Bemnet-Suleman/SAFE_LINK/docs/SAFE_LINK_Final_Requirements_Specifications_Design.docx

SAFE LINK

Requirements, Technical Specifications
and Final System Design

Wearable-Based Group Safety and Participant Monitoring System

Project Documentation
Embedded Systems & IoT
August 2026

# 1. System Requirements

## 1.1 Functional Requirements

- Participant Identification: Each wearable shall have a unique device identifier and shall be associated with a participant and group during registration.
- Emergency SOS Function: A deliberate long-press of a physical SOS button shall generate a high-priority alert containing device identification, available location information, timestamp, and battery status.
- Location Monitoring: The wearable shall obtain participant location using GNSS and retain the most recent valid position as a clearly identified last-known location when live positioning is unavailable.
- Movement and Possible-Fall Detection: An IMU shall monitor movement. The prototype shall use acceleration, orientation change, and subsequent inactivity as indicators of a possible fall.
- Heart-Rate Monitoring: An optical PPG sensor shall periodically measure heart rate as a supporting safety signal, not as a medical diagnosis.
- Battery Monitoring: The system shall monitor battery state and generate low or critical battery warnings.
- Check-in and Attendance: The MVP shall support checkpoint check-in using BLE proximity, with QR-based check-in as a fallback.
- Connection Monitoring: Heartbeat messages shall be used to identify delayed, offline, or unknown devices.
- Geofencing: Organizers shall be able to define safe zones and receive warnings when participants leave them.
- Group-Separation Detection: The system shall identify participants who remain outside a defined distance from their group for a specified period.
- Wearable Integrity Monitoring: A conductive strap loop or equivalent sensor shall detect unexpected wearable removal.
- Organizer Dashboard: The dashboard shall display participant status, location, battery, connection information, and alerts using SAFE, WARNING, CRITICAL, and UNKNOWN states.

## 1.2 Non-Functional Requirements

- Reliability: Sensor and communication failures shall be represented explicitly.
- Low Power Consumption: Adaptive sensor and GNSS sampling shall reduce unnecessary battery use.
- Fail-Safe Operation: Loss of communication shall result in UNKNOWN/OFFLINE rather than SAFE.
- Usability: The dashboard shall emphasize exceptions and actionable alerts.
- Security: Communication and dashboard access shall use appropriate encryption and authentication.
- Privacy: Monitoring information shall be minimized and restricted to authorized organizers.
- Scalability: The prototype shall support a small group of devices with a clear path to larger deployments.
- Maintainability: The system shall use commonly available and well-documented components.

# 2. Technical Specifications

## 2.1 Wearable Hardware

Component | Recommended Specification | Interface | Function
Microcontroller | ESP32-class MCU | — | Main processing and system control
GNSS | u-blox NEO-6M / NEO-M8N class | UART | Participant location
IMU | MPU6050 | I2C | Motion and possible-fall detection
Heart-rate sensor | MAX30102-class PPG | I2C | Supporting heart-rate measurement
Battery fuel gauge | MAX17048-class | I2C | Battery state estimation
Charging IC | TP4056-class | — | Li-ion battery charging
SOS button | Tactile momentary switch | GPIO / interrupt | Emergency alert
Status indicator | LED | GPIO | Status indication
Feedback | Vibration motor | GPIO/PWM | User confirmation
Integrity sensor | Conductive strap loop | GPIO | Removal/tamper detection
Communication | BLE | Wireless | Wearable-to-gateway link

## 2.2 Communication Specifications

The final MVP communication architecture shall use the following structure:

Wearable → BLE → Gateway → Wi-Fi/Cellular → Backend Server → Organizer Dashboard

BLE is the recommended wearable-to-gateway method for the MVP. For larger or more spread-out deployments, a LoRa-based communication layer may be considered as a future upgrade. The gateway shall forward wearable data to the backend and should buffer data during temporary Internet outages.

## 2.3 Software Specifications

### Wearable Firmware

- Read sensors and process movement information.
- Detect local events such as SOS, possible falls, prolonged inactivity, and removal.
- Monitor battery and communication status.
- Buffer important events.
- Control wireless communication and user feedback.

### Gateway Software

- Receive data from multiple wearables.
- Maintain wearable communication.
- Buffer information during Internet outages.
- Forward data to the backend server.

### Backend Server

- Receive telemetry from the gateway.
- Maintain participant and device information.
- Evaluate alert rules.
- Store current participant states.
- Provide data to the organizer dashboard.

### Organizer Dashboard

- Display participant status and locations.
- Show active alerts and last-known locations.
- Display battery and connection information.
- Allow organizers to acknowledge and resolve alerts.

# 3. Final System Design

## 3.1 Overall Architecture

WEARABLE
ESP32 + GNSS + MPU6050 + MAX30102
+ Battery Monitor + SOS + Strap Sensor
|
BLE
v
GATEWAY
|
Wi-Fi / Cellular
v
BACKEND SERVER
Database + Alert Engine
|
v
ORGANIZER DASHBOARD
SAFE / WARNING / CRITICAL / UNKNOWN

## 3.2 Wearable Internal Design

The ESP32 acts as the central controller. It coordinates the sensors, performs initial processing, manages communication, and controls the LED and vibration feedback.

- GNSS → location acquisition through UART.
- MPU6050 → motion and possible-fall detection through I2C.
- MAX30102 → supporting heart-rate measurement through I2C.
- Battery/fuel gauge → battery status through I2C.
- SOS button → emergency input through GPIO/interrupt.
- Conductive strap loop → wearable integrity detection through GPIO.
- BLE → communication from wearable to gateway.
- LED and vibration motor → local user feedback.

## 3.3 Data Flow

1. Sensor Collection: The wearable collects location, motion, heart-rate supporting data, battery state, connection status, and strap-integrity information.

2. Local Processing: The ESP32 processes sensor information and identifies locally detectable events.

3. Wireless Transmission: Normal telemetry is transmitted to the gateway through BLE.

4. Gateway Processing: The gateway receives data from wearables and forwards it through Wi-Fi or cellular connectivity.

5. Backend Analysis: The backend updates participant state and evaluates incoming data against alert rules.

6. Alert Generation: Abnormal conditions generate Warning or Critical alerts.

7. Dashboard Display: The organizer dashboard displays status and required information.

8. Organizer Response: The organizer acknowledges, verifies, acts, and records the resolution.

# 4. Alert Classification

Severity | Examples | Organizer Action
Information / Normal | Normal movement, successful check-in, charging | No immediate action
Warning | Low battery, geofence violation, prolonged inactivity, possible separation, wearable removal | Verify and follow up
Critical | SOS activation; possible fall combined with prolonged inactivity; high-confidence emergency combinations | Immediate acknowledgment and response
Unknown | Communication lost or device unavailable | Manual status verification

# 5. Final MVP Scope

## 5.1 Included in the MVP

- ESP32-based wearable controller
- GNSS location
- MPU6050 movement monitoring
- MAX30102 periodic heart-rate monitoring
- SOS button
- Battery monitoring
- BLE communication
- Gateway communication
- Basic backend/database
- Organizer dashboard
- Basic geofencing
- Basic group-separation detection
- Wearable removal detection
- Alert classification
- Local event buffering

## 5.2 Future Enhancements

- Machine-learning-based fall detection
- Advanced indoor positioning
- NFC/RFID checkpoint systems
- Advanced polygon geofencing
- LoRa as the standard communication method
- Satellite communication
- Solar-assisted charging
- Multi-gateway redundancy
- External camp-management integration

# 6. Final Design Summary

The finalized SAFE LINK system is a wearable-based monitoring platform consisting of an ESP32-controlled wearable, sensors, wireless communication, gateway, backend server, database, alert engine, and organizer dashboard.

The wearable collects safety-related information and performs initial processing. The gateway provides communication between wearable devices and the Internet. The backend processes incoming information and determines whether a participant should be classified as SAFE, WARNING, CRITICAL, or UNKNOWN. The organizer dashboard presents this information in a decision-oriented format.

Development shall be incremental: individual subsystems such as GNSS, motion detection, heart-rate sensing, battery monitoring, and communication should first be tested independently. After validation, the subsystems should be integrated into one wearable before final enclosure and field testing.

The final design is intended to provide an achievable student prototype while clearly separating demonstrated prototype capabilities from future development. SAFE LINK is an organized-group safety and accountability system, not a medical diagnostic system or a military-grade tracking system.

SAFE LINK — Requirements, Specifications and Final Design
