Bemnet-Suleman/SAFE_LINK/hardware/PCB_PCB_SAFELINK_carrier_2026-10-18/EasyEDA(Standard) 6.5.51 - Projects Offline mode 10_18_2026 11_13_48 AM.png

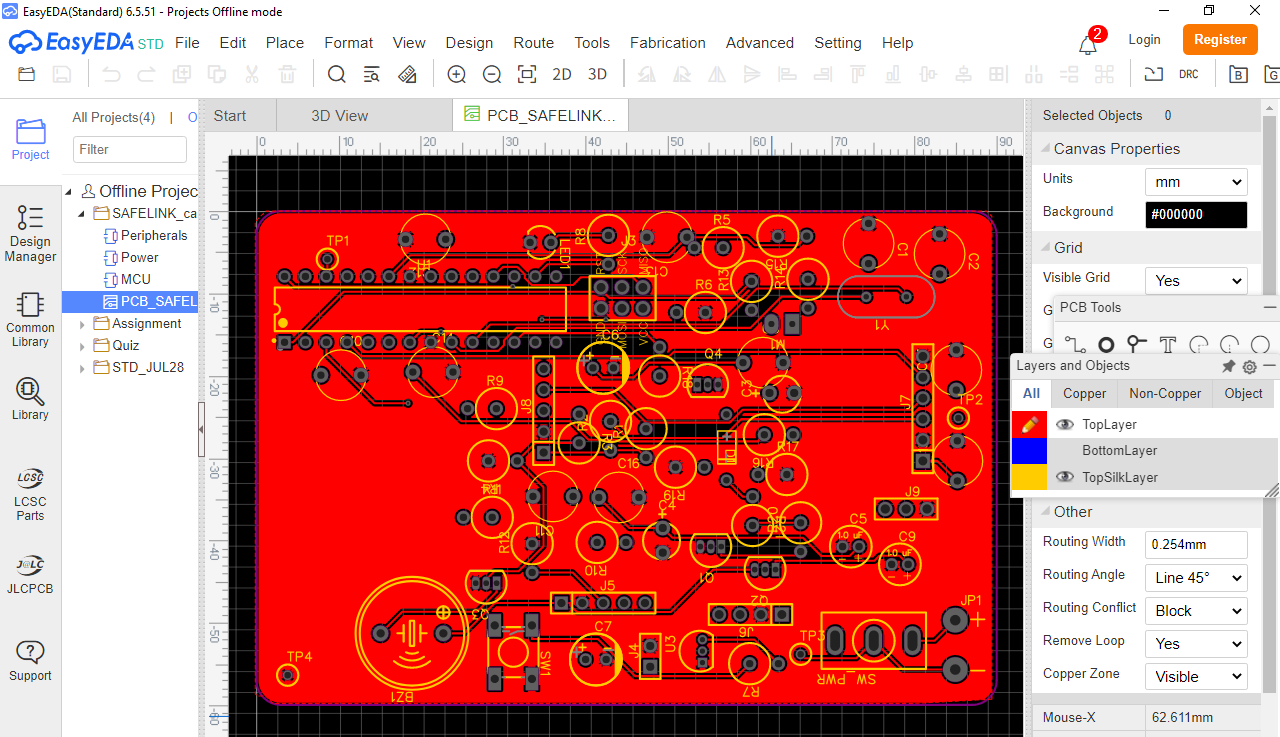
hardware/PCB_PCB_SAFELINK_carrier_2026-10-18/EasyEDA(Standard) 6.5.51 - Projects Offline mode 10_18_2026 11_13_48 AM.png
