Bemnet-Suleman/SAFE_LINK/hardware/PCB_PCB_SAFELINK_carrier_2026-10-18/Screenshot 10_18_2026 11_00_50 AM.png

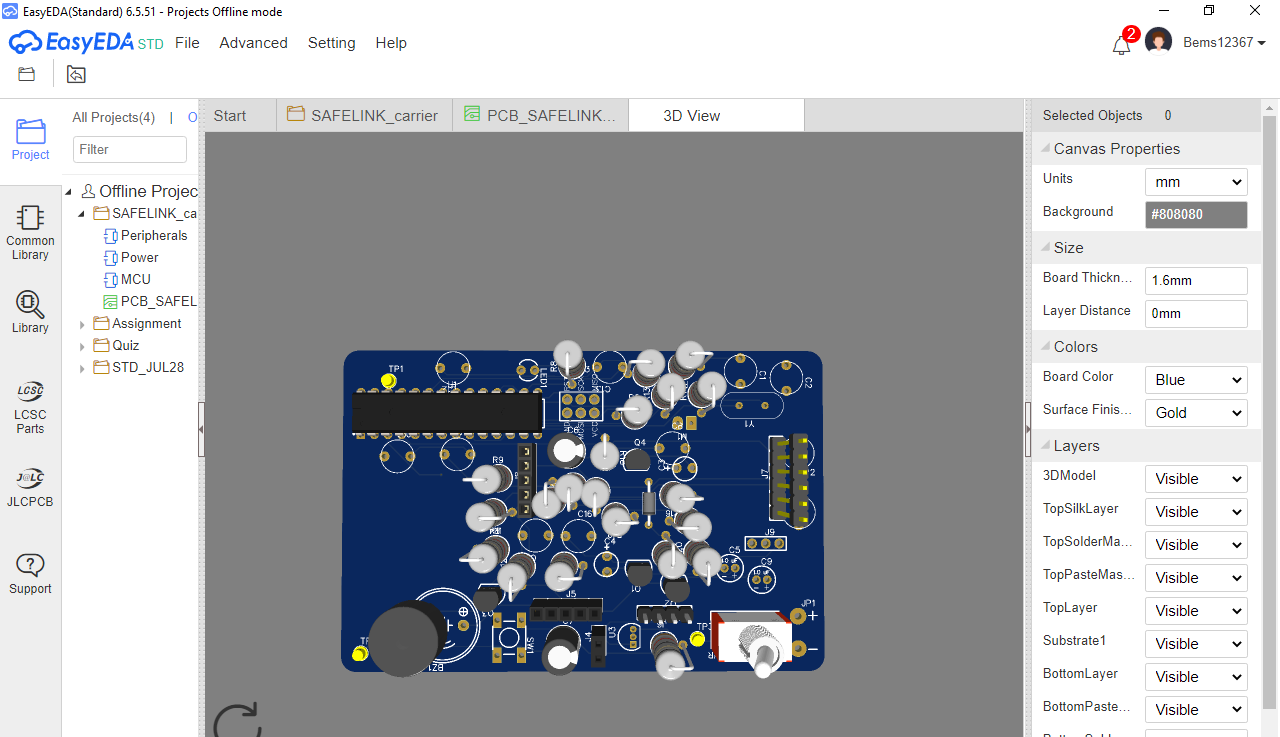
hardware/PCB_PCB_SAFELINK_carrier_2026-10-18/Screenshot 10_18_2026 11_00_50 AM.png
