Bemnet-Suleman/SAFE_LINK/enclosure/A_full_assembly.stl

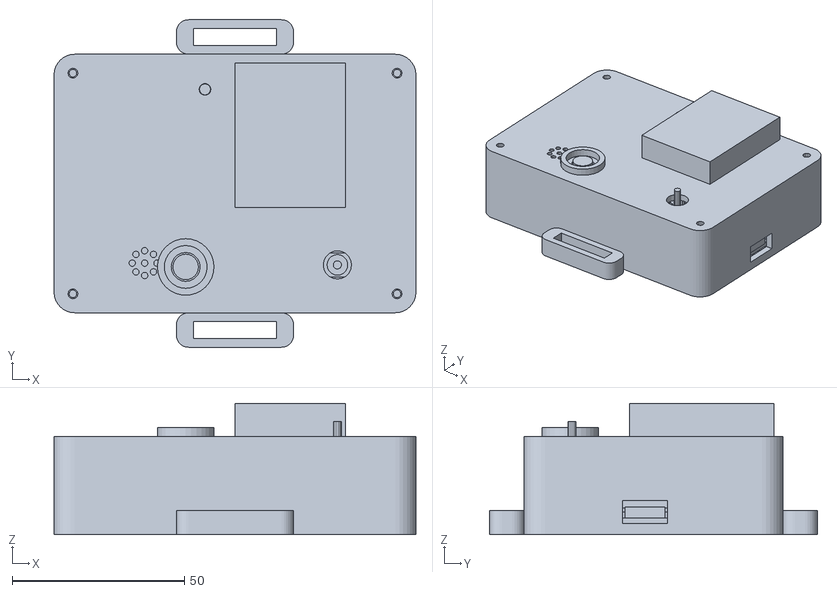
[picture p20: CAD file, 2026-10-19]
enclosure/A_full_assembly.stl
105.0 x 95.0 x 38.0
