Bemnet-Suleman/SAFE_LINK/enclosure/C_full_assembly.stl

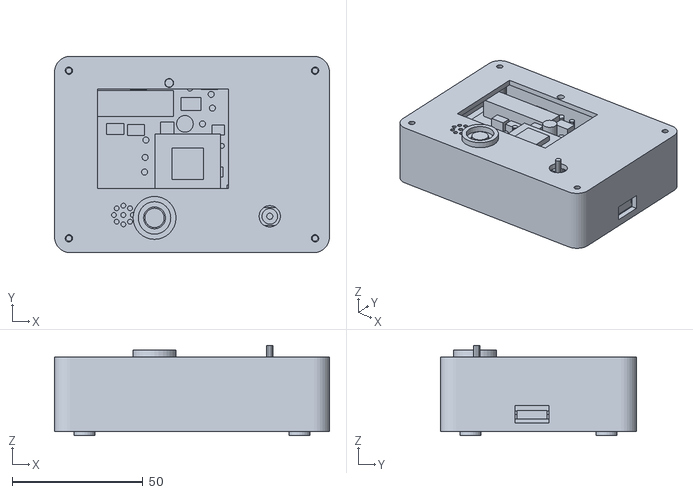
[picture p21: CAD file, 2026-10-19]
enclosure/C_full_assembly.stl
105.0 x 75.0 x 34.4
