Bemnet-Suleman/SAFE_LINK/enclosure/B_full_assembly.stl

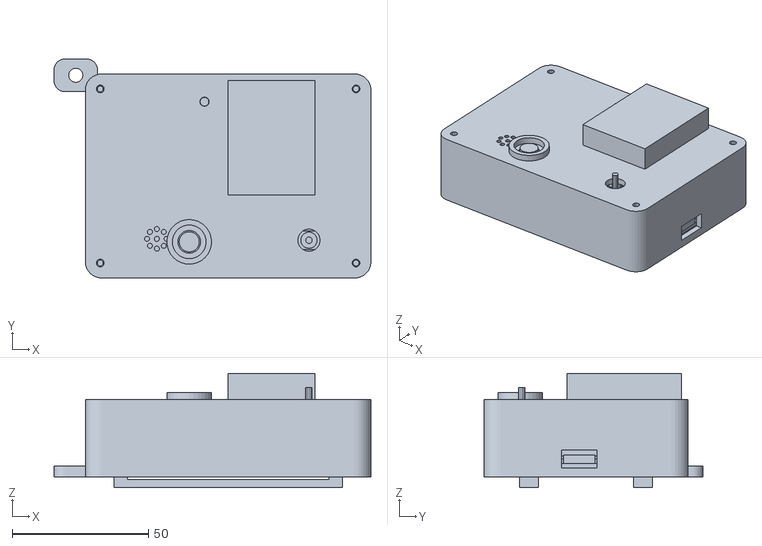
[picture p22: CAD file, 2026-10-19]
enclosure/B_full_assembly.stl
116.5 x 80.5 x 42.0
