Bemnet-Suleman/SAFE_LINK/enclosure/A_lid.stl

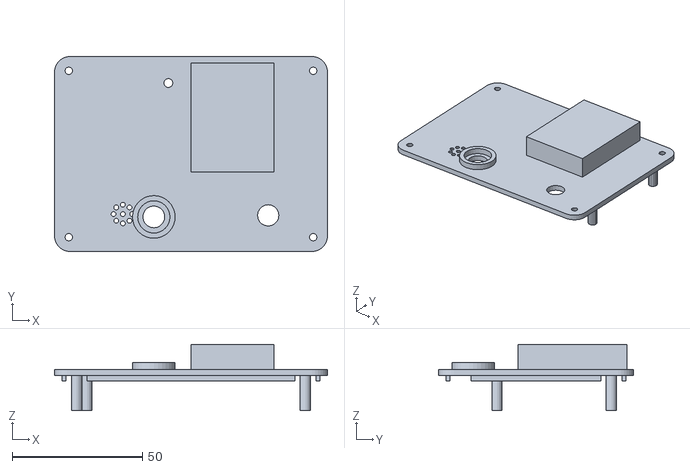
[picture p23: CAD file, 2026-10-19]
enclosure/A_lid.stl
105.0 x 75.0 x 25.4
