Bemnet-Suleman/SAFE_LINK/enclosure/B_base.stl

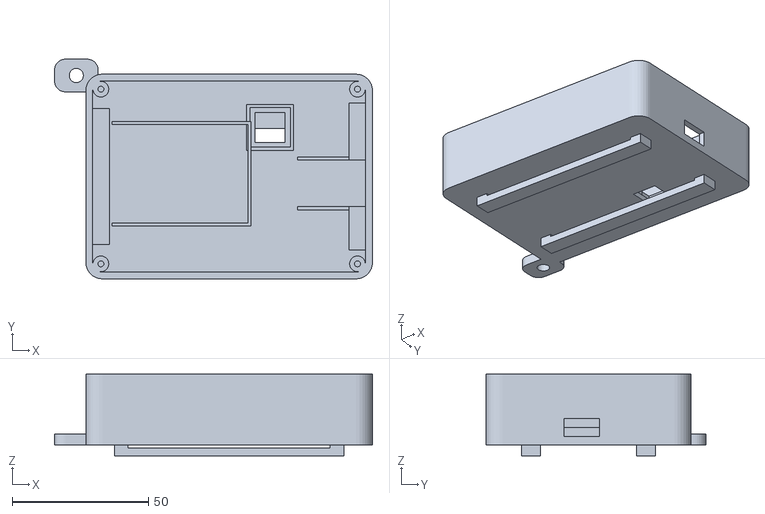
[picture p24: CAD file, 2026-10-19]
enclosure/B_base.stl
116.5 x 80.5 x 30.0
