Bemnet-Suleman/SAFE_LINK/enclosure/A_base.stl

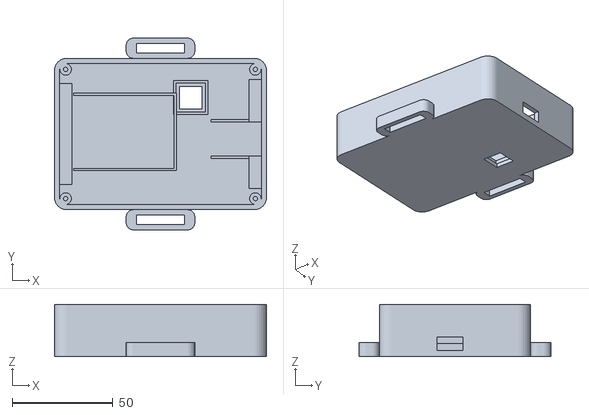
[picture p25: CAD file, 2026-10-19]
enclosure/A_base.stl
105.0 x 95.0 x 26.0
