Bemnet-Suleman/SAFE_LINK/enclosure/C_base.stl

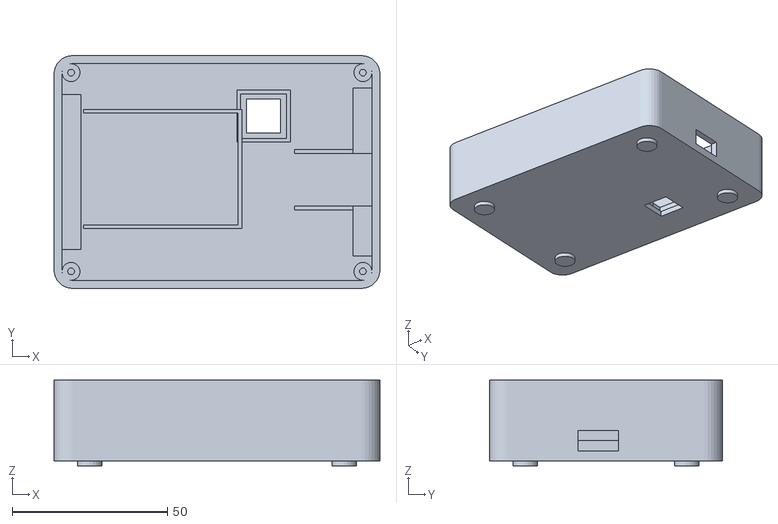
[picture p26: CAD file, 2026-10-19]
enclosure/C_base.stl
105.0 x 75.0 x 27.6
