Bemnet-Suleman/SAFE_LINK/enclosure/sos_plunger.stl

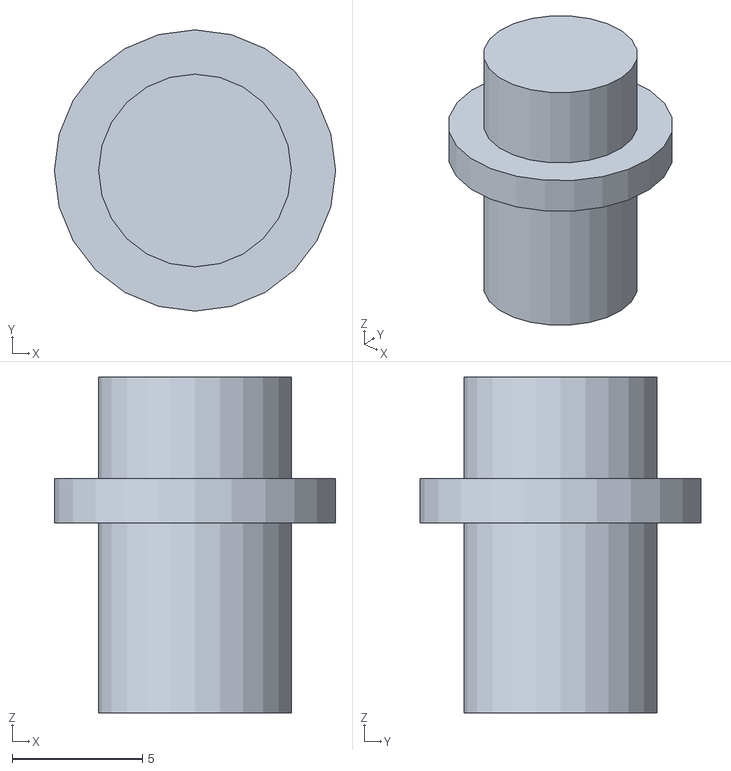
[picture p27: CAD file, 2026-10-19]
enclosure/sos_plunger.stl
10.8 x 10.8 x 12.9
