Bemnet-Suleman/SAFE_LINK/enclosure/C_lid.stl

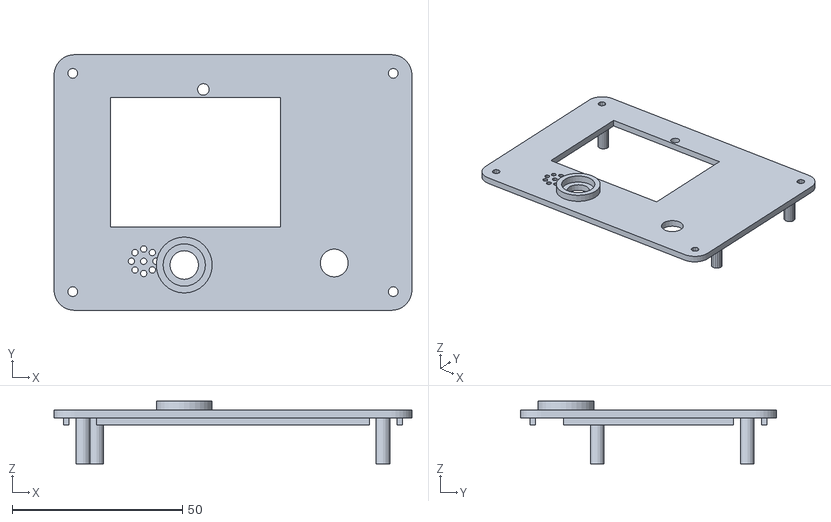
[picture p28: CAD file, 2026-10-19]
enclosure/C_lid.stl
105.0 x 75.0 x 18.4
