Bemnet-Suleman/SAFE_LINK/hardware/PCB_PCB_SAFELINK_carrier_2026-10-18/PCB_PCB_SAFELINK_carrier_2026-10-1(Two Layers).pdf

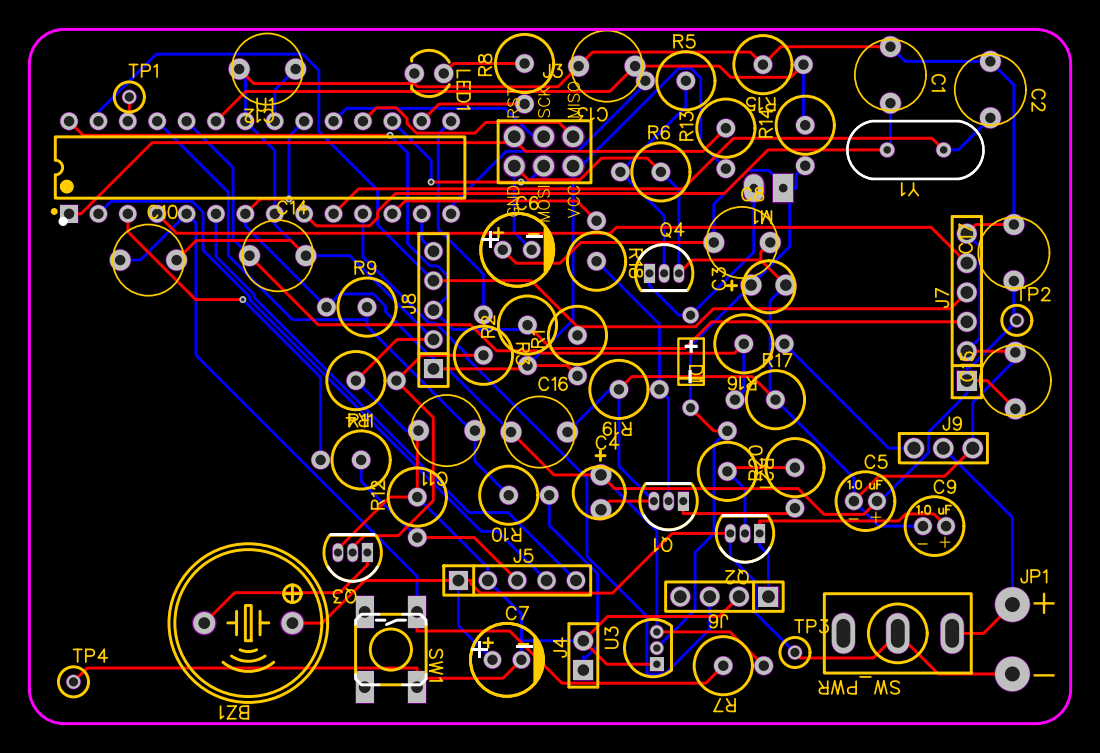
[picture p29: page 1]
