Bemnet-Suleman/SAFE_LINK/(list of files, drawings)

Other design files:
simulation/safe link proteuse simulation.pdsprj
