Bemnet-Suleman/SAFE_LINK/(commit log)

2026-10-11 Design resource concerned schematics, enclosure, firmware etc.
2026-10-19 Designed Enclosure and PCB OUTLINE concluding phase 0.
    [A_base.stl, A_full_assembly.stl, A_lid.stl, B_base.stl, B_full_assembly.stl, C_base.stl, C_full_assembly.stl, C_lid.stl]
2026-10-24 Firmware files added with the consideration of the new board design with rough guesses on some parts.
