Bemnet-Suleman/SAFE_LINK/(notices)

Notices in the files:
README.md:
License: MIT
